kkaya674/EE464-TermProject/Reports/Feedback sunumu .pptx

## EE464 Feedback Session

Mert Eren Kandilli
Emre Çakmakyurdu
Kubilay Kaya

## Overview

- Topology Selection
- Magnetic Design
  - Core Selection
  - Cable Selection
  - Winding
- Component Selection
  - MOSFET Selection
  - Diode Selection
  - Output Capacitor Selection
- Controller Design
  - IC Selection
  - Design
  - Efficiencies

## Slide 3

Topology Selection

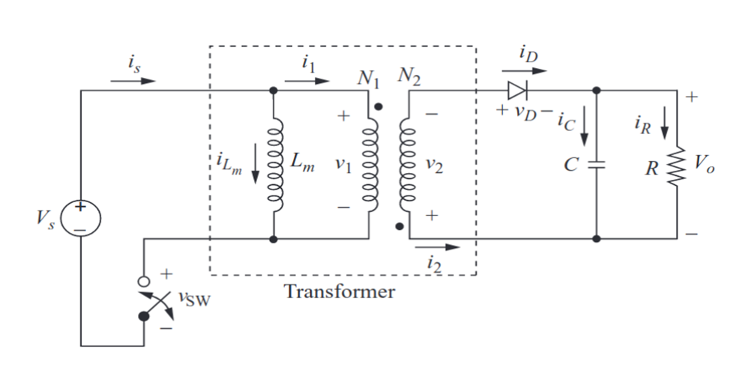
[picture p1: figure]

Flyback Converter

## Slide 4

ADVANTAGES
● Design is simple compared to other DC-DC topologies
● Switching element count is less.
● It can operate in a wide range of input voltages.
● Cost is less than other DC-DC topologies.
DISADVANTAGES
● Ripple at the output current is higher.
● Core is gapped so EMI problems can occur.
● Losses are increased.
● Requires additional snubber circuit to discharge the leakage inductance in the transformer.

## Magnetic Design

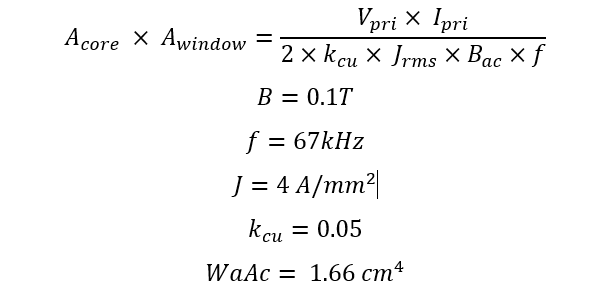
[picture p2: figure]

## Slide 6

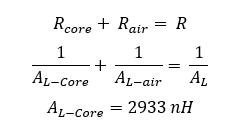
[picture p3: figure]
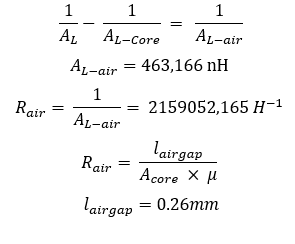
[picture p4: figure]

## Slide 7

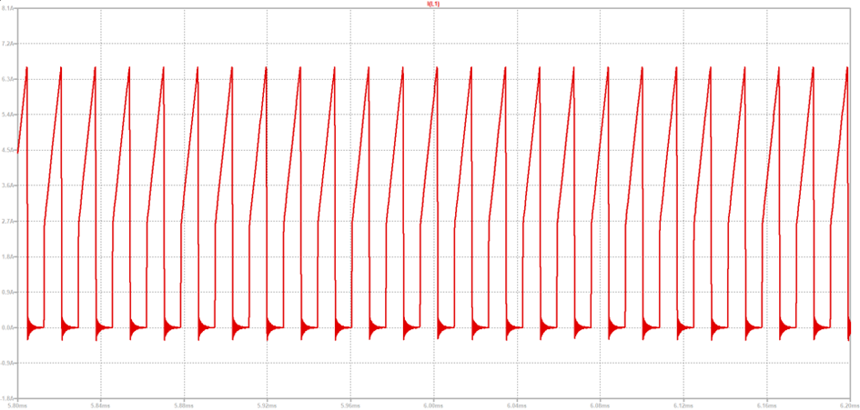
[picture p5: figure]

Figure : Primary Side Current Waveform

Primary Current RMS Value : 3.3A

## Slide 8

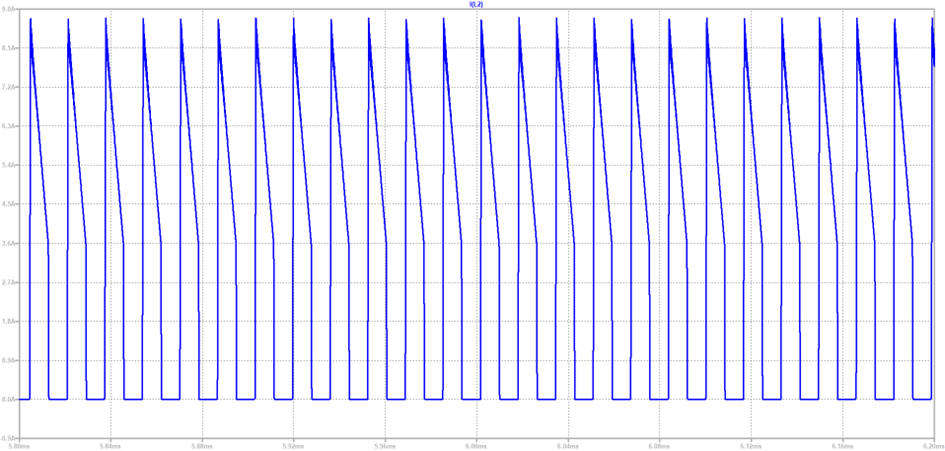
[picture p6: figure]

Figure: Secondary Side Current

RMS Current: 4.3A

## Slide 9

## Slide 10

MAGNETIZING INDUCTANCE

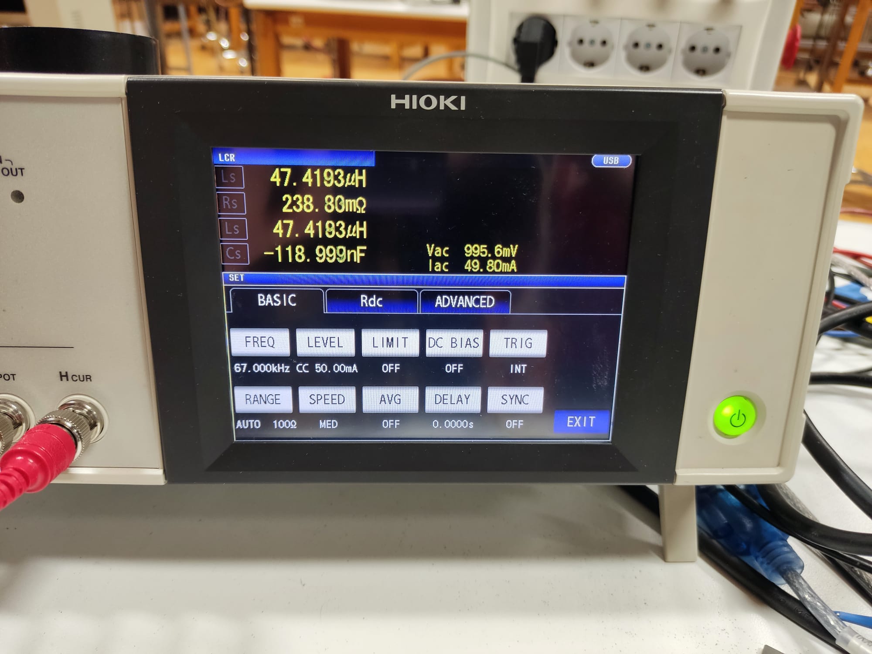
[picture p7: figure]

## Slide 11

LEAKAGE INDUCTANCE

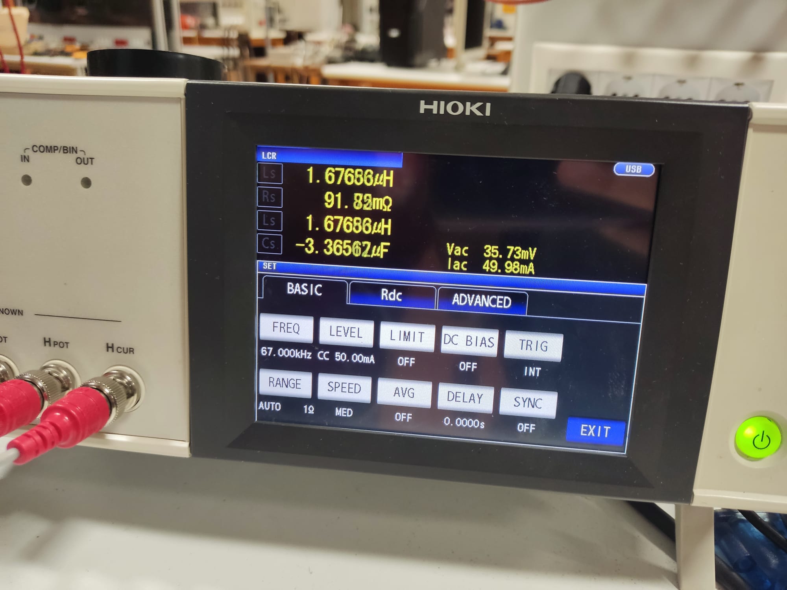
[picture p8: figure]

## Component Selection

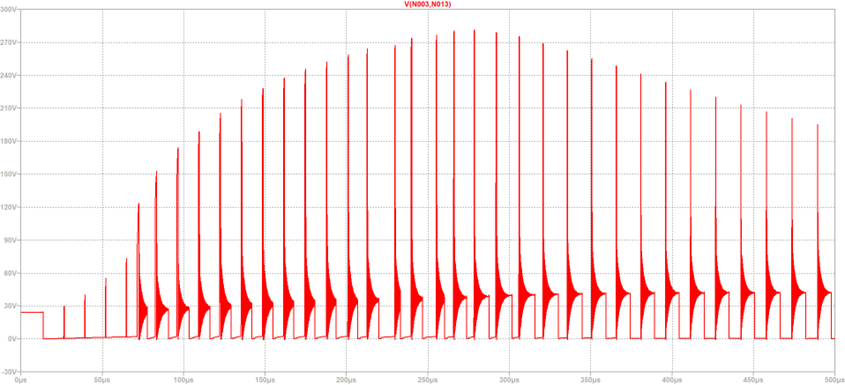
[picture p9: figure]

MOSFET Selection

MOSFET Voltage Waveform Transient (24V Input)

## Slide 13

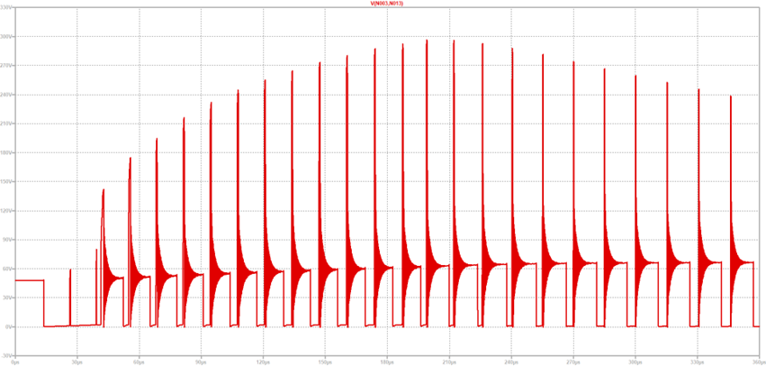
[picture p10: figure]

MOSFET Voltage Waveform Transient (48V Input)

## Slide 14

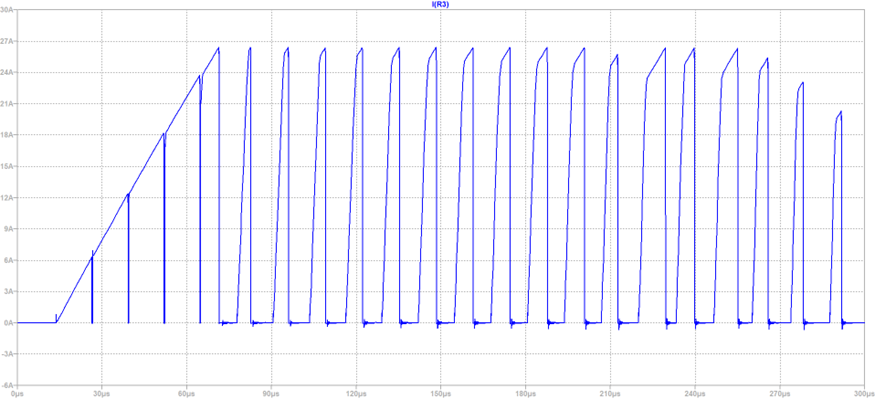
[picture p11: figure]

MOSFET Current Waveform Transient (24V Input)

## Slide 15

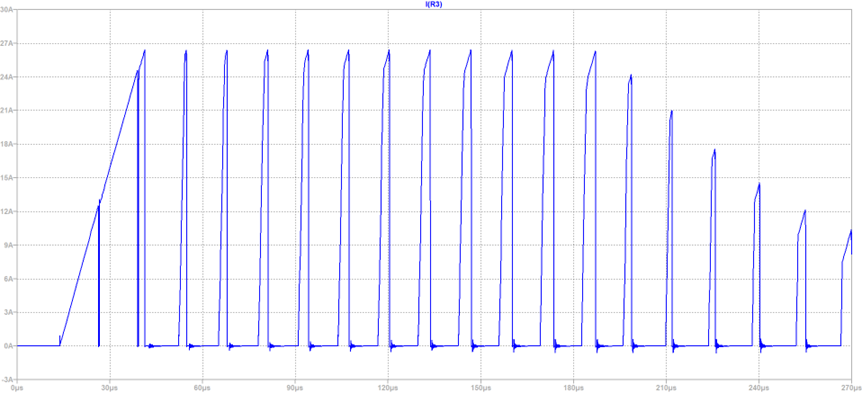
[picture p12: figure]

MOSFET Current Waveform Transient (48V Input)

## Slide 16

Vin | Peak Voltage | Peak Current
24 V | ~280 V | ~27 A
48 V | ~300 V | ~27 A

IXFP38N30X3M N-Channel MOSFET
300 V
38 A

## Component Selection

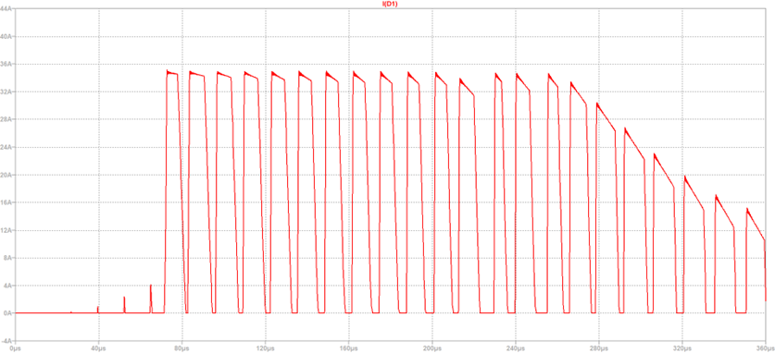
[picture p13: figure]

Diode Selection

Diode Current Waveform Transient (24V Input)

## Slide 18

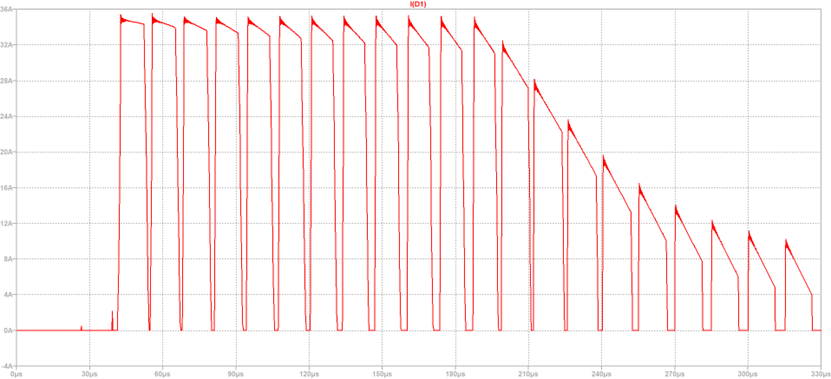
[picture p14: figure]

Diode Current Waveform Transient (48V Input)

## Slide 19

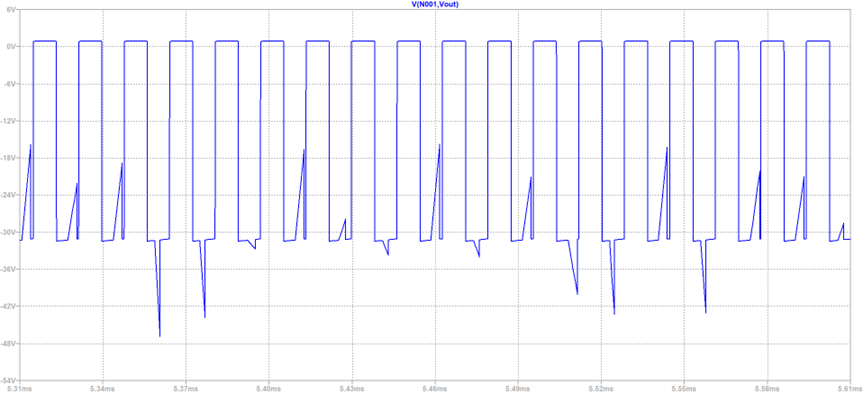
[picture p15: figure]

Diode Voltage Waveform Steady State (24V Input)

## Slide 20

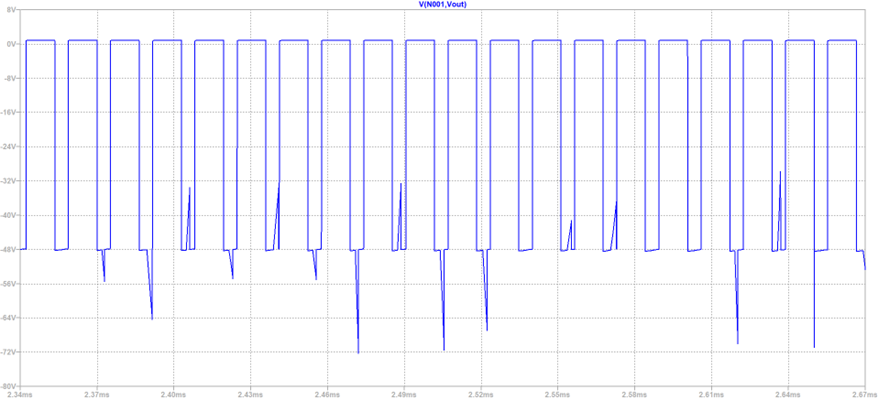
[picture p16: figure]

Diode Voltage Waveform Steady State (48V Input)

## Slide 21

Vin | Peak Voltage | Peak Current
24 V | ~-48 V | ~35 A
48 V | ~-72 V | ~35 A

ESAF92-03R Diode
300 V
60 A

## Component Selection

Capacitor Selection

470uF 25 V electrolytic capacitor is selected.

## Controller Design

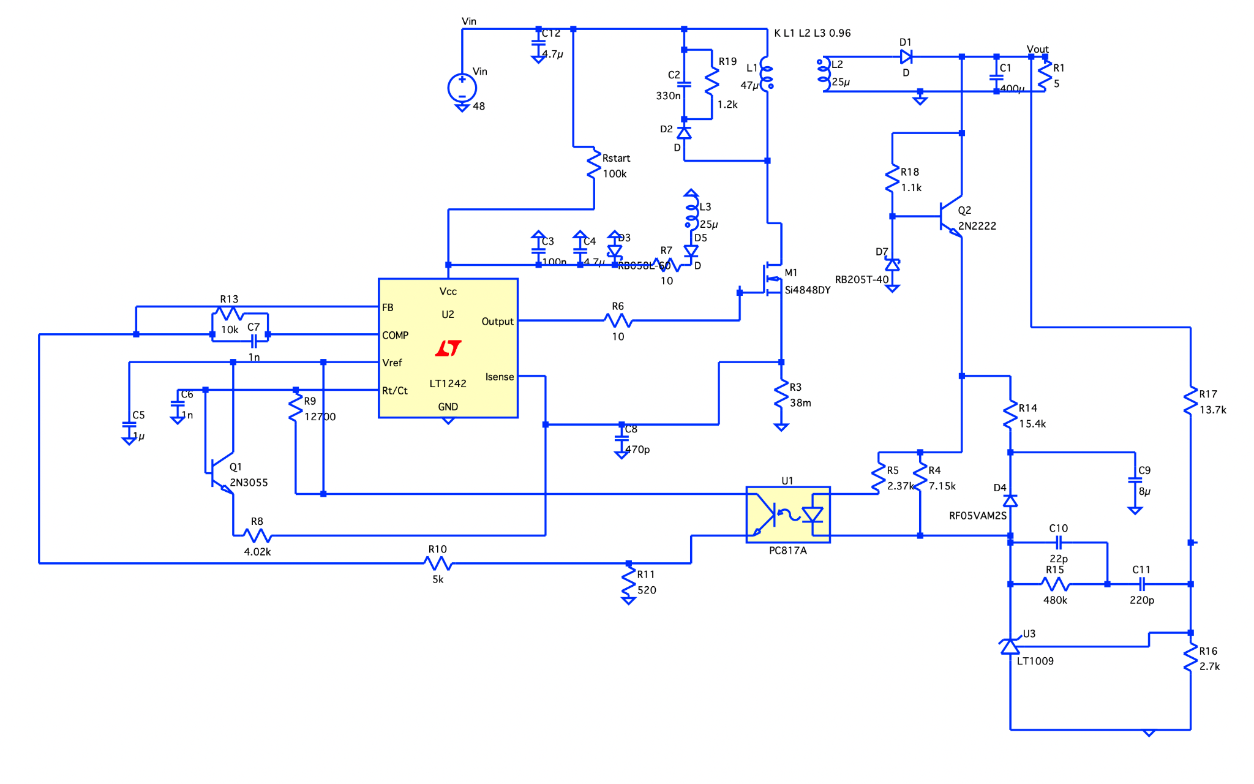
[picture p17: figure]

## IC Selection : UC3842

Advantages
- Can be found in Turkish Market
- Very cheap w.r.t other ICs
- Voltage can be controlled using a POT
- Current Mode Control
- A desired frequency can be controlled by changing resistor and capacitor
- Can drive MOSFET gate without any additional circuit component
Disadvantages
- Requires a third winding in order to feed the input pin.

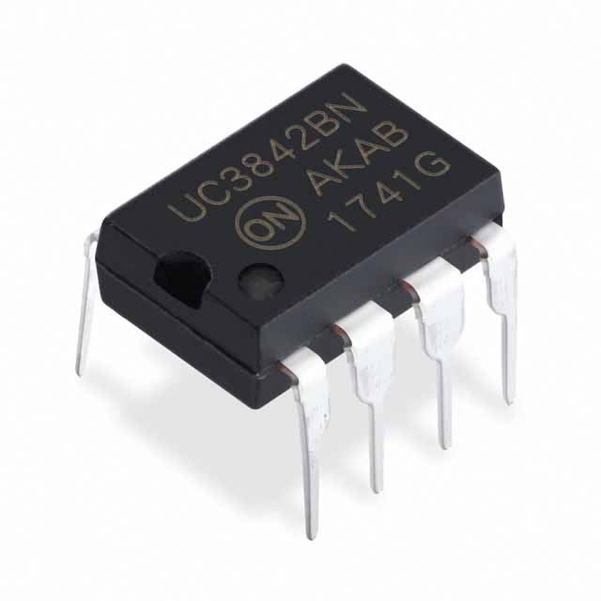
[picture p18: figure]

## Isolation

- In order to obtain physical isolation between primary and secondary side,we need to use an optocoupler.
- Output voltage can be controlled used R5 and R11. When we changed this resistors, the sensibility of feedback also changes. It effects the Vref voltage. Finally, the output voltage is determined.

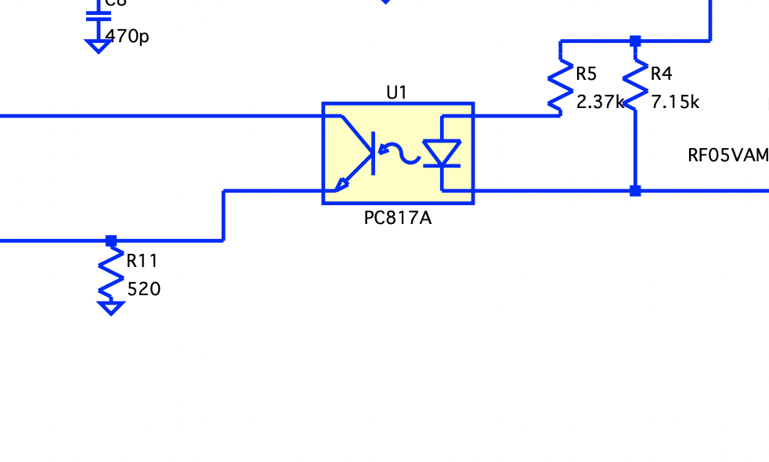
[picture p19: figure]

## Expected Efficiencies

- In the simulation report, we used arbitrary MOSFET and Diodes in order to understand basics of the controller design.
- Finally, we have chosen suitable components (diodes, mosfets). Then, efficiency is increased from 80% to 89%.

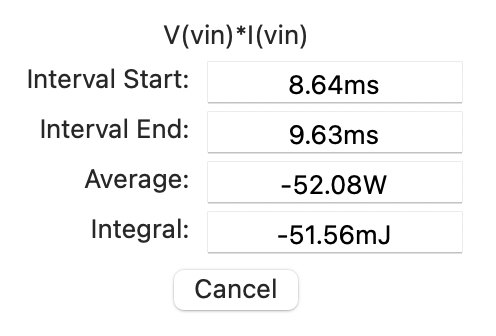
[picture p20: figure]
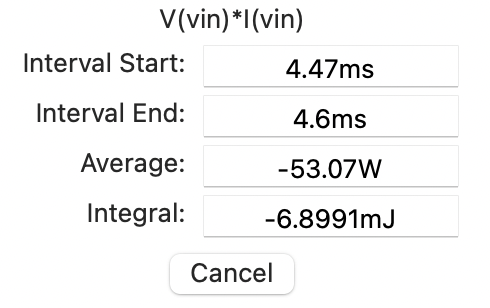
[picture p21: figure]

48 & 24V Input Voltages
