kkaya674/EE464-TermProject/Magnetic Design/Magnetic Design .docx

Magnetic Design

In order to design magnetic design, first the area product is calculated.

A_(core) × A_(window) =(V_(pri) × I_(pri))/(2×k_(cu) × J_(rms) ×B_(ac) ×f)

B=0.1T

f=67kHz

J=4 A/mm^2

k_(cu) =0.05

WaAc= 1.66 cm^4

To have a realistic core model fill factor is chosen as 0.05. According to the research, frequency of 67kHz is the most used frequency for flyback converter, it might be said that 67kHz is the standard. After calculating the area product, available component list is checked and 0P43434EC is chosen. Then sample circuits are investigated in Texas Instruments web page. For flyback converter UC3842 is the most used current mode controller, therefore we decided to use that integrated chip.

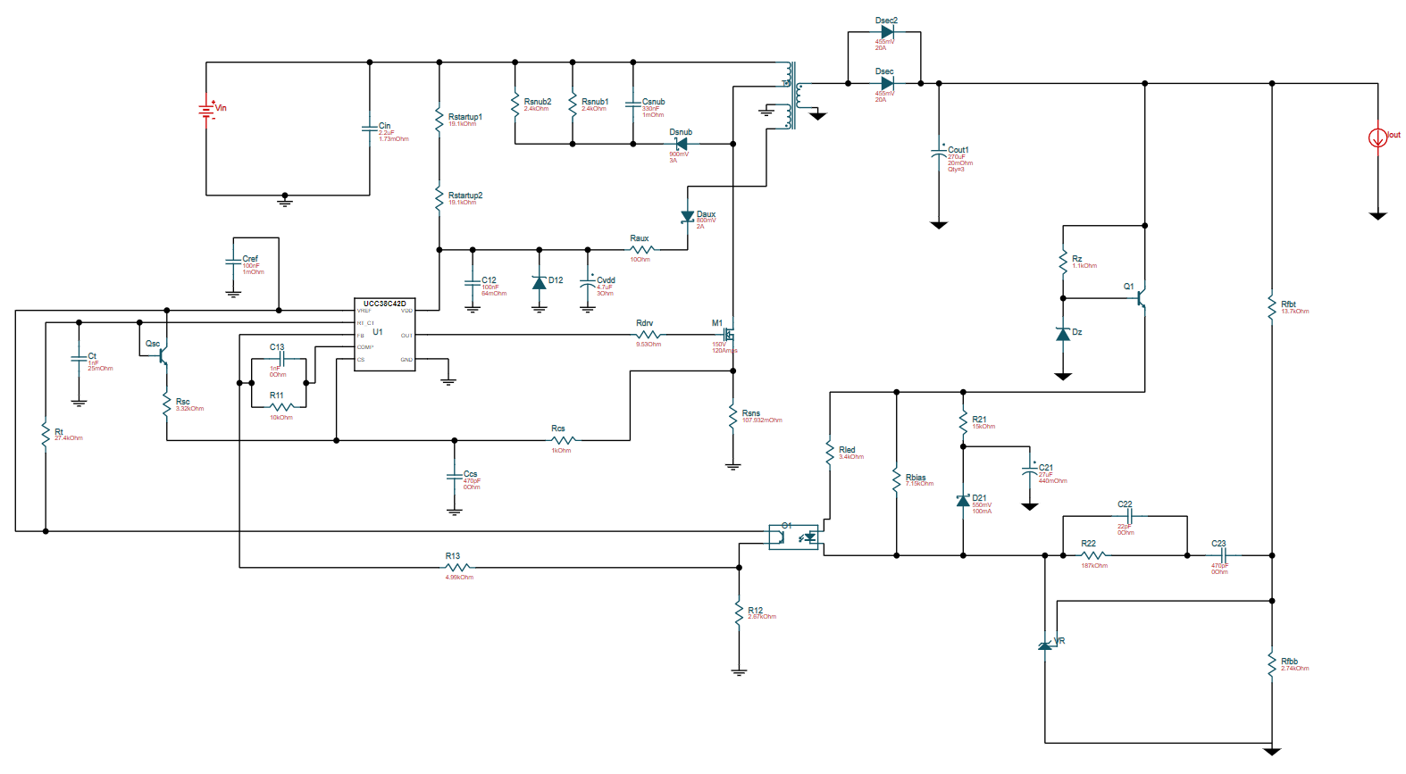
[picture p22: figure]

Figure xx: Sample Flyback Converter Circuit with UC3842

In this circuit the magnetizing inductance of primary side is calculated as 42uH and 47uH is decided to be used to have less current ripple. Then minimum number of turns is calculated to not to saturate the core.

N_(primary-minimum) = (V_(primary))/(4×B_(ac) ×A_(core) ×f)=5

Number of turns is chosen as 1.375 then;

N_(primary-minimum) =4

These values are the minimum number of turns for primary and secondary.

In order to achieve 47uH, there should be some airgap in the core. To find the airgap, one should obtain the required air reluctance.

R_(core) + R_(air) = R

1/(A_(L-Core))+ 1/(A_(L-air))= 1/(A_L)

A_(L-Core) =2933 nH

In order to have meaningful air gap AL is chosen as 400nH.

1/(A_L)- 1/(A_(L-Core)) = 1/(A_(L-air))

A_(L-air) =463,166 nH

R_(air) = 1/(A_(L-air))= 2159052,165 H^(-1)

R_(air) = (l_(airgap))/(A_(core) × μ)

l_(airgap) =0.26mm

Considering an A4 paper, this airgap value corresponds about 2 A4 paper width. After airgap calculations, number of turns is calculated to achieve 47uH magnetizing inductance.

N_(primary) = √((L_(magnetizing))/(A_L))≅11

N_(secondary) =8

CABLE SELECTION

In order to select an appropriate cable for transformer, RMS current on the primary and secondary side of the transformer are simulated.

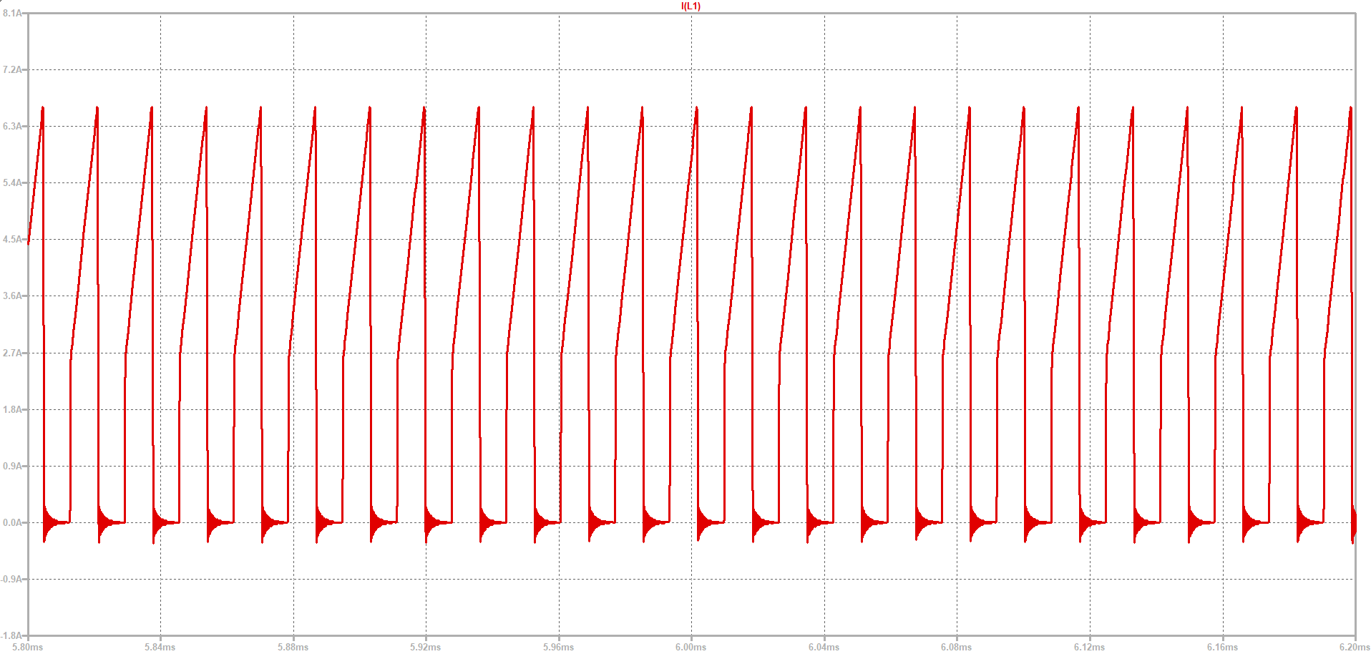
[picture p23: figure]

Figure xx: Current Waveform on Primary Side

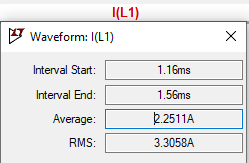
[picture p24: figure]

Figure xx: RMS Value of IL1

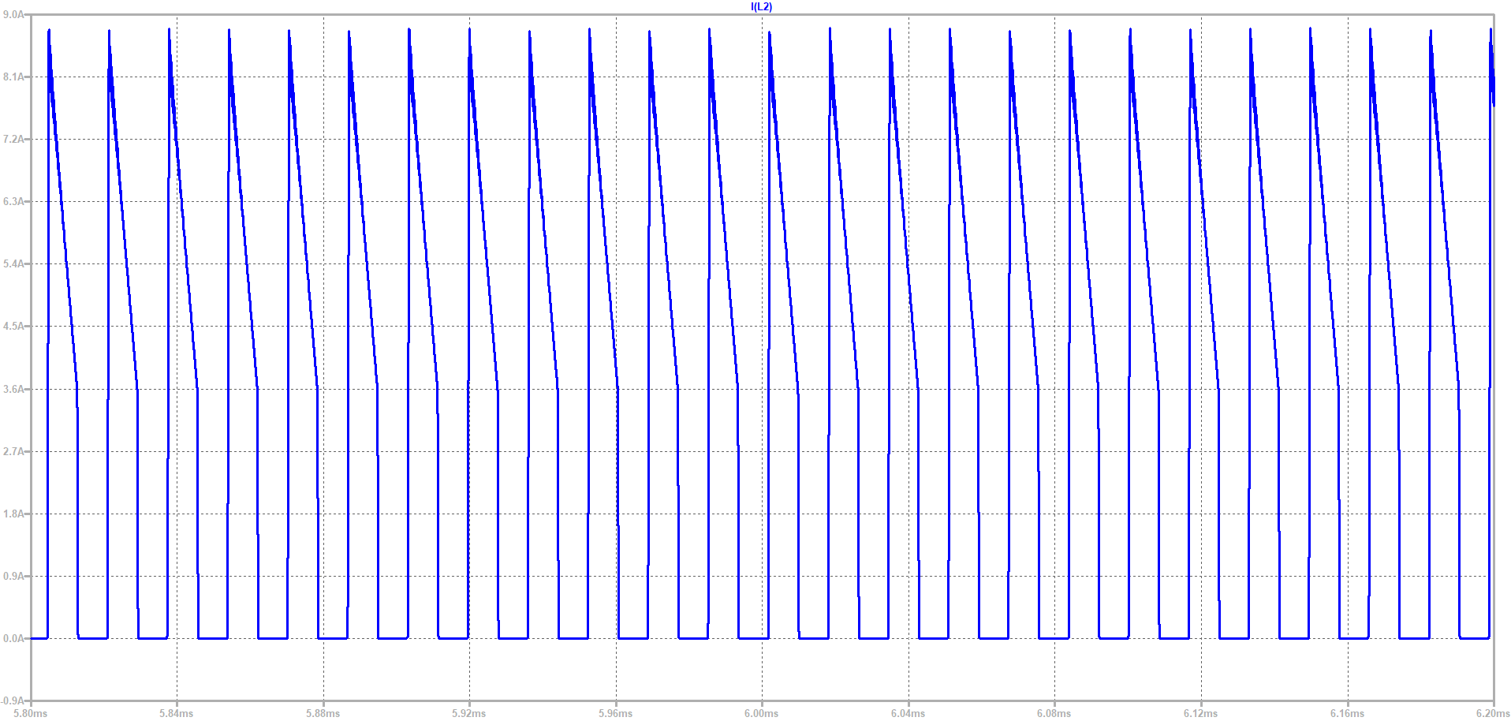
[picture p25: figure]

Figure xx: Current Waveform on Secondary Side

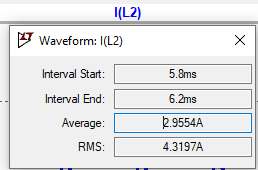
[picture p26: figure]

Figure xx: RMS Value of IL2

According to the results, current on primary side 3.4A and on secondary side is 4.32A.

J=4 A/mm^2

Table xx: Cable Parameters

AWG Number | Conductor Cross Section Area(mm2) | Ohms Per mm | Maximum Frequency for 100% Skin Depth
26 | 0.162 | 0.0001061736 | 85kHz

For primary side

Number of Cables in Primary Side= (I_(L1-RMS))/(J×Cross Section Area)≅5

For secondary side

Number of Cables in Secondary Side= (I_(L2-RMS))/(J×Cross Section Area)≅7

According to the calculations, cables should be paralleled, 5 for primary and 7 for secondary. To do that, we twisted the cables to prevent proximity effect. After winding the transformer, we measured its inductance and leakage inductance.

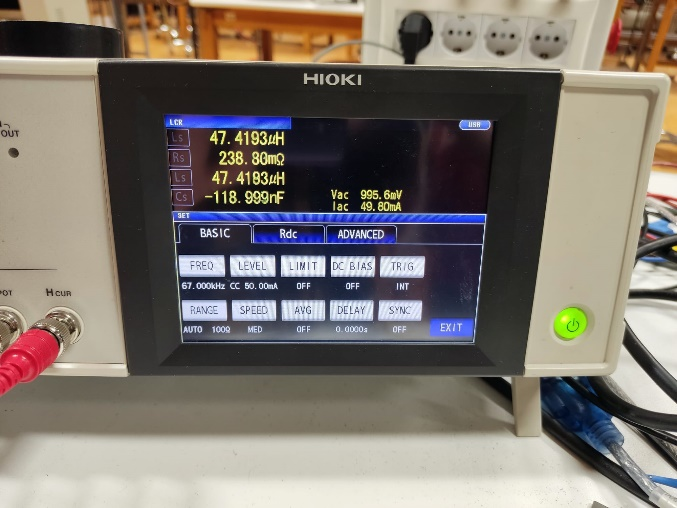
[picture p27: figure]
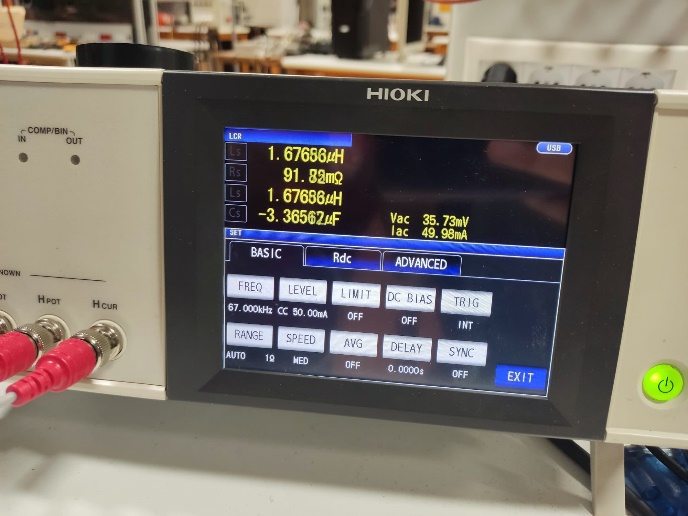
[picture p28: figure]

Figure xx: Inductance Measurement Figure xx: Leakage Inductance Measurement

In order to measure the leakage inductance, secondary side is shorted. Note that, since cables are isolated, to measure isolation on the cables are removed. However, because they are not removed completely the resistance is higher than expected. Leakage inductance is higher than the standards, it is because winding operation is completed without tools.
