kkaya674/EE464-TermProject/Reports/Efficiencies.xlsx

Input Voltage | Output Voltage | Input Current | Output Current | Pin | Pout | Efficiency
48.5 | 15.15 | 0.33 | 0.747 | 16.005 | 11.31705 | 70.70946579
48.5 | 15.15 | 0.43 | 1 | 20.855 | 15.15 | 72.64444977
48.5 | 15.1 | 0.8 | 1.999 | 38.8 | 30.1849 | 77.79613402
48.6 | 15.07 | 1.18 | 3.008 | 57.348 | 45.33056 | 79.04470949
36.4 | 15.15 | 0.5 | 0.878 | 18.2 | 13.3017 | 73.08626374
36.4 | 15.14 | 0.56 | 1.002 | 20.384 | 15.17028 | 74.42248823
36.4 | 15.1 | 1.07 | 2.005 | 38.948 | 30.2755 | 77.73313135
36.4 | 15.09 | 1.56 | 3 | 56.784 | 45.27 | 79.72316145
24.5 | 15.15 | 0.64 | 0.724 | 15.68 | 10.9686 | 69.95280612
24.5 | 15.14 | 0.84 | 1.007 | 20.58 | 15.24598 | 74.08153547
24.5 | 15.1 | 1.66 | 2 | 40.67 | 30.2 | 74.25620851
24.5 | 15.07 | 2.37 | 3.007 | 58.065 | 45.31549 | 78.04269353
