kkaya674/EE464-TermProject/Controller/Hesaplamalar/Ekran Resmi 2022-05-14 12.52.46.png

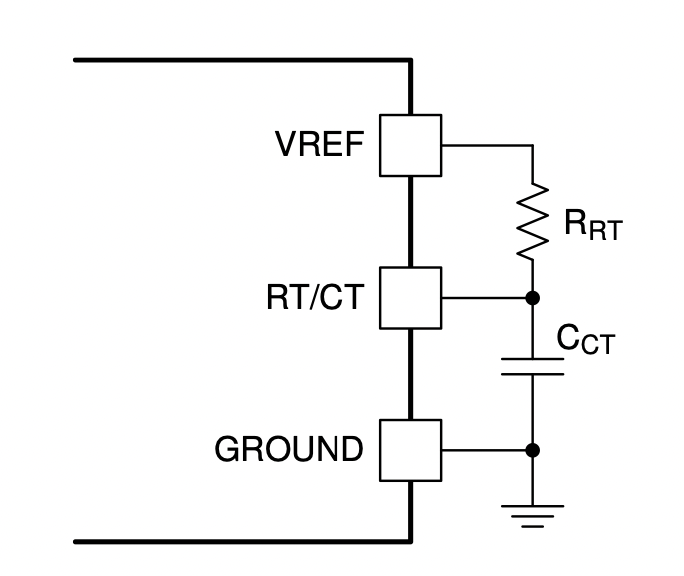
Controller/Hesaplamalar/Ekran Resmi 2022-05-14 12.52.46.png
