kkaya674/EE464-TermProject/Reports/efficiency24.png

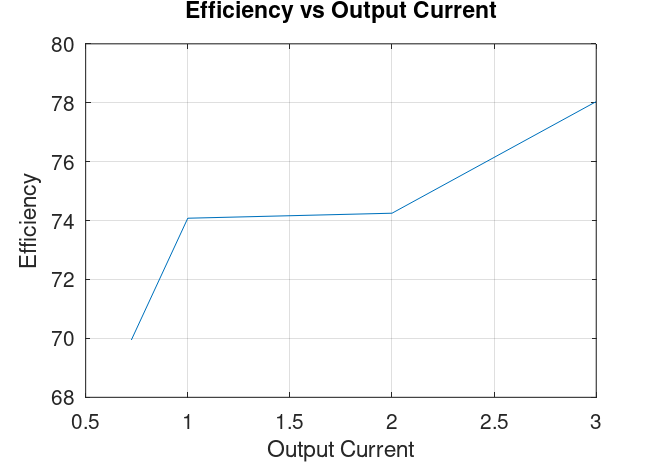
Reports/efficiency24.png
