kkaya674/EE464-TermProject/Reports/efficiency48.png

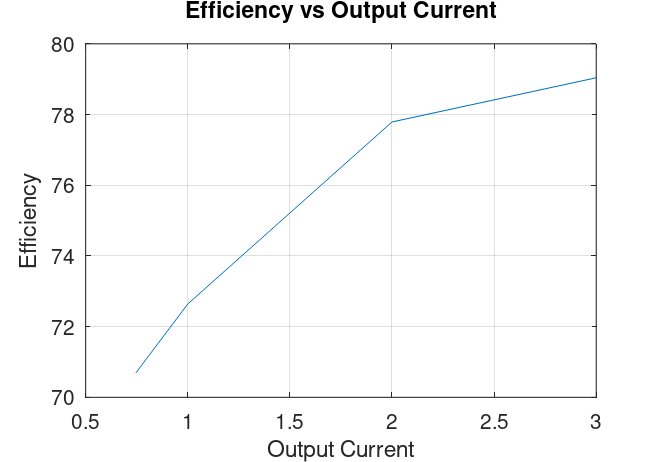
Reports/efficiency48.png
