kkaya674/EE464-TermProject/Useful Application Notes/Datasheets/Controller Sample Circuit.jpg

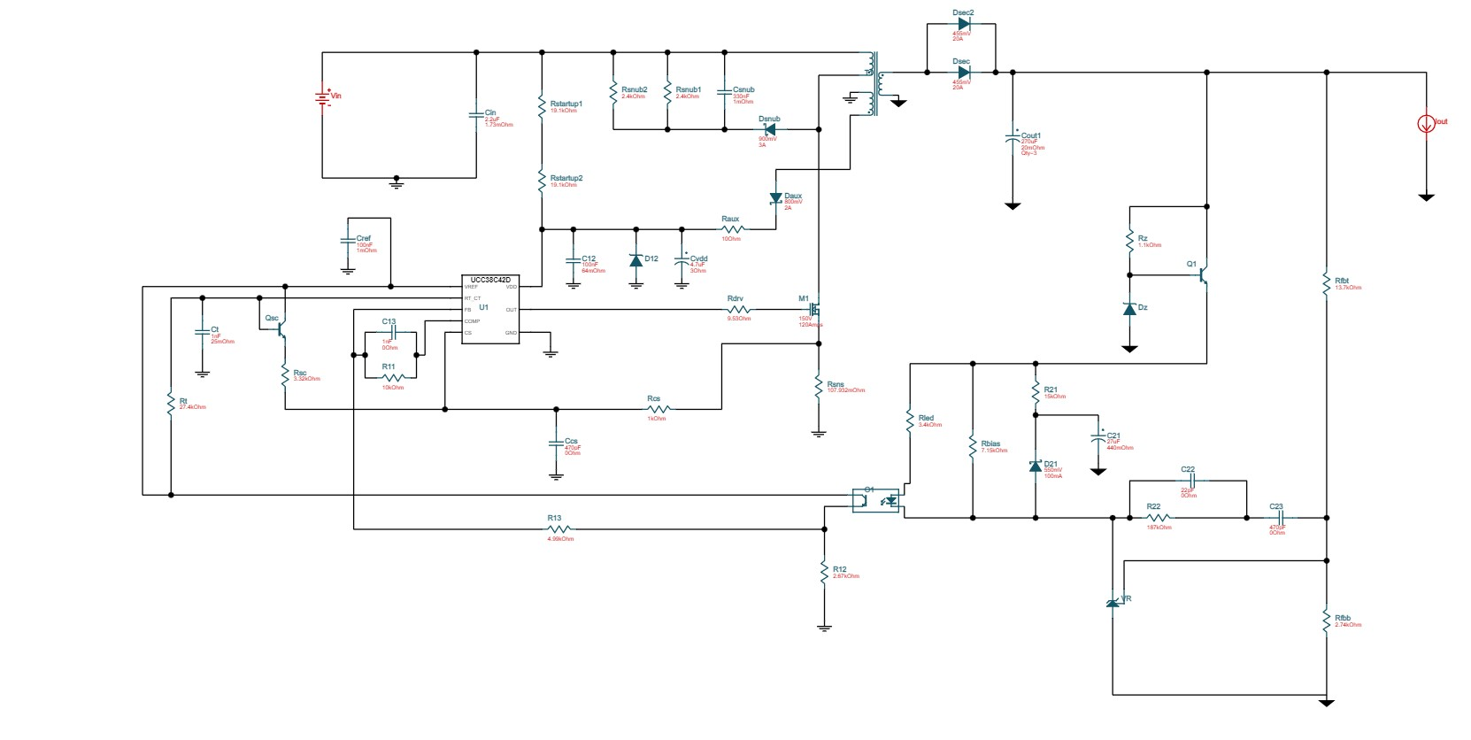
Useful Application Notes/Datasheets/Controller Sample Circuit.jpg
