kkaya674/EE464-TermProject/Reports/CostList_EE464.xlsx

Component | Count | Total Price (TL)
IC-431 VOLTAGE REFERENCE | 1 | 1.33 |  | Sütun1 | Sütun2 | Sütun3
MOSFET DIS.76A 250V N-CH | 1 | 87.88
IC-817 OPTOC.TRANS | 1 | 1.4
IC-2842 PWM BOOST FLYBACK | 1 | 14.7
DIODE ZENER 500mW 10V | 1 | 0.37
DIODE ZENER 500mW 17V | 1 | 0.19
DIODE SCHOTTKY 30A 100V | 1 | 25.38
RES.CEMENT 5W 150 Ohms | 1 | 2.8
RES.(3216) 1206 10 Ohms | 2 | 0.2
RES.(3216) 1206 1K Ohms | 2 | 0.2
RES.(3216) 1206 2400 Ohms | 2 | 0.2
RES.(3216) 1206 1K Ohms | 3 | 0.3
RES.(3216) 1206 150 Ohms | 1 | 0.1
RES.(3216) 1206 5.6K Ohms | 3 | 0.3
RES.(3216) 1206 2.21K Ohms | 1 | 0.1
RES.(3216) 1206 12K Ohms | 1 | 0.1
RES.(3216) 1206 100K Ohms | 1 | 0.47
RES.(3216) 1206 0.1 Ohms | 1 | 0.1
MLCC (3216) 1206 1nF 100VDC | 2 | 1.6
MLCC (3216) 1206 1uF 100VDC | 2 | 1.6
MLCC (3216) 1206 2.2nF 50VDC | 1 | 1.5
MLCC (3216) 1206 470pF 200VDC | 1 | 3.2
MLCC (3216) 1206 2.2uF 100VDC | 3 | 8.7
CAP.EL.100uF 50V | 2 | 7.52
MLCC (3216) 1206 100nF 50VDC | 1 | 0.258
 |  | 160.498
 |  |  | 160.498
