kkaya674/EE464-TermProject/Controller/controller3.asc

C1: cap; 400µ
C2: cap; 4.7µ; Rser=3m
C3: cap; 100n
C4: cap; 4.7µ
C5: cap; 1µ
C6: cap; 1n
C7: cap; 1n
C8: cap; 470p
C9: cap; 8µ; Rser=27u
C10: cap; 22p
C11: cap; 220p; Rser=82p
C12: cap; 4.7µ; Rser=5m
D1: diode
D2: diode
D3: schottky; RB058L-60
D4: diode; RF05VAM2S
D5: diode
D7: schottky; RB205T-40
L1: ind2; 47µ
L2: ind2; 30µ
L3: ind2; 30µ
M1: nmos; Si4848DY
Q1: npn; 2N3055
Q2: npn; 2N2222
R1: res; 5
R2: res; 5k
R3: res; 38m
R4: res; 7.15k
R5: res; 2.37k
R6: res; 10
R7: res; 10
R8: res; 4.02k
R9: res; 12700
R10: res; 5k
R11: res; 520
R13: res; 10k
R14: res; 15.4k
R15: res; 480k
R16: res; 2.7k
R17: res; 13.7k
R18: res; 1.1k
Rstart: res; 100k
U1: PC817A
U2: LT1242
U3: LT1009
V1: voltage; 15
V2: voltage; 15
Vin: voltage; 24
Named nets: 15, 0, -15, Vout, Vin
.tran 0 20m 10m
K L1 L2 L3 0.96
