kkaya674/EE464-TermProject/Controller/Last Controller/Flyback_with_Controller_Final.asc

C1: cap; 400µ
C2: cap; 330n
C3: cap; 100n
C4: cap; 4.7µ
C5: cap; 1µ
C6: cap; 1n
C7: cap; 1n
C8: cap; 470p
C9: cap; 8µ; Rser=27u
C10: cap; 22p
C11: cap; 220p; Rser=82p
C12: cap; 4.7µ; Rser=5m
D1: schottky; RB215T-60
D2: diode; RFUH20TJ6S
D3: zener; PTZ30B
D4: diode; RF05VAM2S
D5: diode
D7: schottky; RB205T-40
L1: ind2; 47µ
L2: ind2; 25µ
L3: ind2; 25µ
M1: nmos; IPI110N20N3
Q1: npn; 2N3055
Q2: npn; 2N2222
R1: res; 5
R2: res; 100k
R3: res; 100m
R4: res; 7.15k
R5: res; 2.37k
R6: res; 10
R7: res; 10
R8: res; 4.02k
R9: res; 12700
R10: res; 5k
R11: res; 400
R13: res; 10k
R14: res; 15.4k
R15: res; 480k
R16: res; 2.7k
R17: res; 13.7k
R18: res; 1.1k
R19: res; 220
Rstart: res; 100k
U1: PC817A
U2: LT1242
U3: LT1009
V1: voltage; 15
V2: voltage; 15
Vin: voltage; 48
Named nets: 15, 0, -15, Vout, Vin
K L1 L2 L3 0.96
.tran 20m
