kkaya674/EE464-TermProject/Controller/Last Controller/Flyback_with_Controller_softstart.asc

C1: cap; 400µ
C2: cap; 330n
C3: cap; 100n
C4: cap; 4.7µ
C5: cap; 1µ
C6: cap; 1n
C7: cap; 1n
C8: cap; 470p
C9: cap; 10µ; Rser=27u
C10: cap; 22p
C11: cap; 220p; Rser=82p
C12: cap; 4.7µ; Rser=5m
D1: schottky; RB215T-60
D2: diode; RFUH20TJ6S
D3: zener; PTZ16B
D4: diode; RF05VAM2S
D5: diode
D7: schottky; RB205T-40
L1: ind2; 47µ
L2: ind2; 25µ
L3: ind2; 25µ
M1: nmos; IPI110N20N3
Q2: npn; 2N2222
R1: res; 5
R3: res; 0.1
R4: res; 8.2k
R5: res; 2200
R6: res; 10
R7: res; 10
R9: res; 12700
R10: res; 4.7k
R11: res; 400
R13: res; 10k
R14: res; 15k
R15: res; 470k
R16: res; 3.3k
R17: res; 15k
R18: res; 1k
R19: res; 10k
R20: res; 1k
Rstart: res; 10k
U1: PC817A
U2: LT1242
U3: LT1009
V1: voltage; 15
V2: voltage; 15
Vin: voltage; 24
Named nets: 15, 0, -15, Vout, Vin, Vef, Comp, FB, 1, 2, 3, 4, 5, 6, 7, 8
K L1 L2 L3 0.96
.tran 10m
