kkaya674/EE464-TermProject/(commit log)

2022-05-08 Controller3 dosyası asıl dizayn. 15V output
    [Core&CableSelection.xlsx, KubilayCoreCalculation.xlsx, Project Core Calculations (version 1) (2).xlsx]
2022-05-13 Candidate controller is uploaded. Sample circuit for UC3842 is added
2022-05-14 In LTSpice scheme, some updates are done to reduce the losses.
    [KubilayCoreCalculation.xlsx]
2022-05-14 Isense'deki direnci cıkartınca output voltajları arasındaki farklılık kayboldu. Sebepleri daha irdelenmedi
2022-05-14 Magnetic design report version 1 is uploaded It includes core selection and windings
2022-05-15 Core calculation excel table is added
    [Core&CableSelection.xlsx, Project Core Calculations (version 1) (2).xlsx, Project Core Calculations (version 1).xlsx]
2022-07-02 Final Report is added
    [CostList_EE464.xlsx, Efficiencies.xlsx]
